ccycyc6/51car/(list of files, cad)

Other CAD files:
code/testmotor1/Objects/testmotor.obj
code/testmotor2/Objects/testmotor2.obj
