ccycyc6/51car/ysyx_car/turn.h

#ifndef __TURN_H__
#define __TURN_H__

extern unsigned char zkb1;
extern unsigned char zkb2;
extern unsigned char t;

void init(void);
void turn_left1(void);
void turn_left2(void);
void turn_right1(void);
void turn_right2(void);
void qianjin(void);
void stop(void);

#endif
